Nivek-domotic/ttgo-cc2652p2/README.md

passerelle Zigbee CC2652 +TTGO
Le système est composé de 2 cartes, la TTGO avec un ESP32
Et une carte sur mesure composé d’un coordinateur Zigbee CC2652P2
