Nivek-domotic/ttgo-cc2652p2/Utilisation passerelle Zigbee CC2652.pdf

# Utilisation passerelle Zigbee CC2652 +TTGO

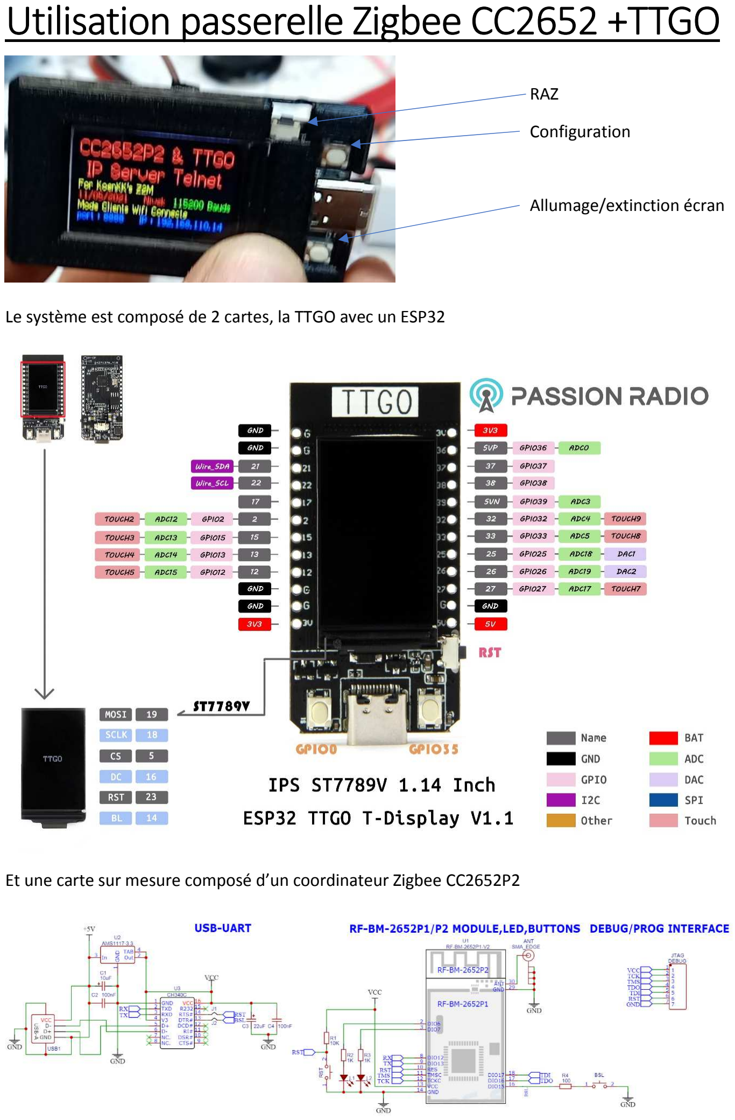
[picture p1: page 1]

RAZ

Configuration

Allumage/extinction écran

Le système est composé de 2 cartes, la TTGO avec un ESP32

Et une carte sur mesure composé d’un coordinateur Zigbee CC2652P2

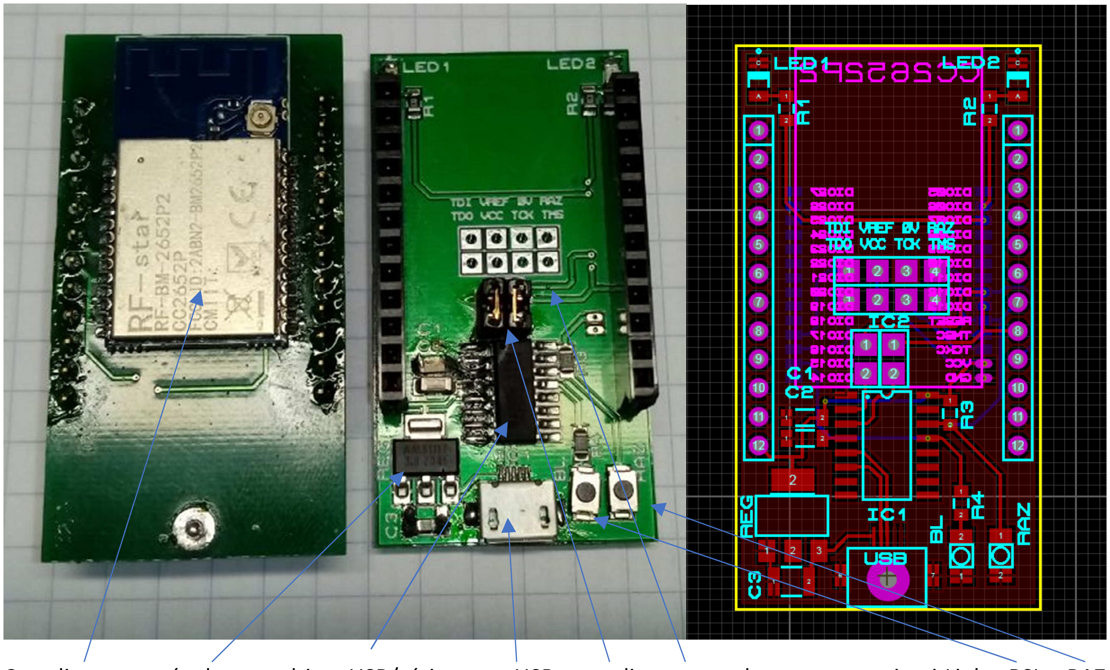
[picture p2: figure]

Coordinateur – régulateur - driver USB/série - port USB – cavaliers – port de programmation j-Link – BSL – RAZ

Cette carte peut être branchée directement sur la box Jeedom en USB avec les cavaliers.

Dans ce mode on pourrait la flasher directement en la passant en mode BSL (BOOT Start Loader) en appuyant sur le bouton BSL et en branchant l’USB puis en relâchant le bouton BSL (non testé)

Le flash, firmware et les conseils sont décrite sur le site de KOENKK créateur de Z2M

https://github.com/Koenkk/Z-Stack-firmware/tree/master/coordinator/Z-Stack_3.x.0/bin

la bonne version a utiliser dans notre cas est

CC1352P2_CC2652P_launchpad_coordinator_20210120.zip.

Pour un fonctionnement avec la TTGO il faut enlever les cavalier car c’est la TTGO qui va virtualiser la connexion série en IP par le protocole « Telnet » sur le port « 8888 »

Les port port virtualiser la connexion serie tx rx du coordinateur sont les gpio 26 et 25 le reset du coordinateur est en port gpio 33.

# UTILISATION

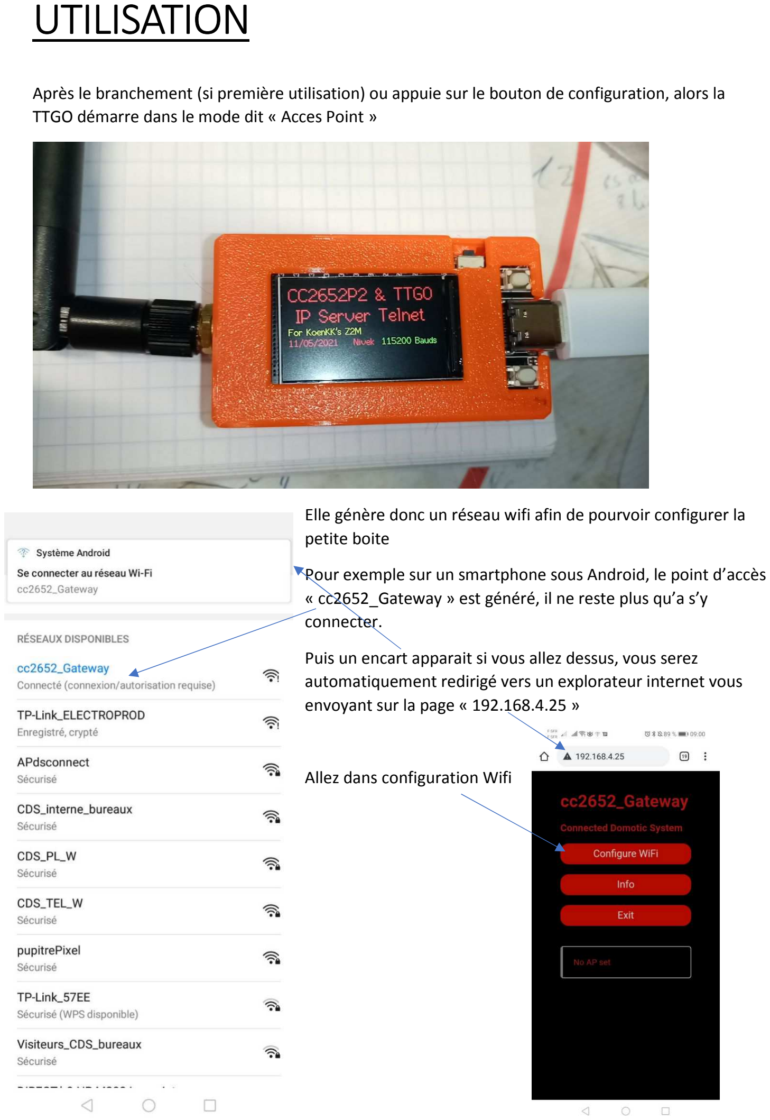
[picture p3: page 3]

Après le branchement (si première utilisation) ou appuie sur le bouton de configuration, alors la TTGO démarre dans le mode dit « Acces Point »

Elle génère donc un réseau wifi afin de pourvoir configurer la petite boite

Pour exemple sur un smartphone sous Android, le point d’accès « cc2652_Gateway » est généré, il ne reste plus qu’a s’y connecter.

Puis un encart apparait si vous allez dessus, vous serez automatiquement redirigé vers un explorateur internet vous envoyant sur la page « 192.168.4.25 »

Allez dans configuration Wifi

Renseigner votre SSID et mot de passe de votre wifi

Puis « Save »

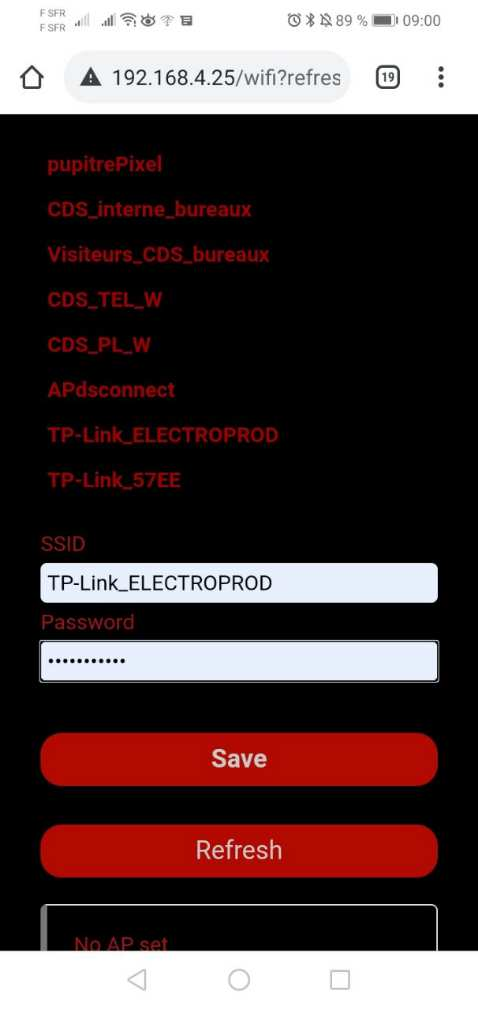
[picture p4: figure]

Le boitier redémarre après avoir enregistré dans sont EEPROM vos informations, ce qui permettra de les avoir en mémoire après une coupure de courant ou un redémarrage.

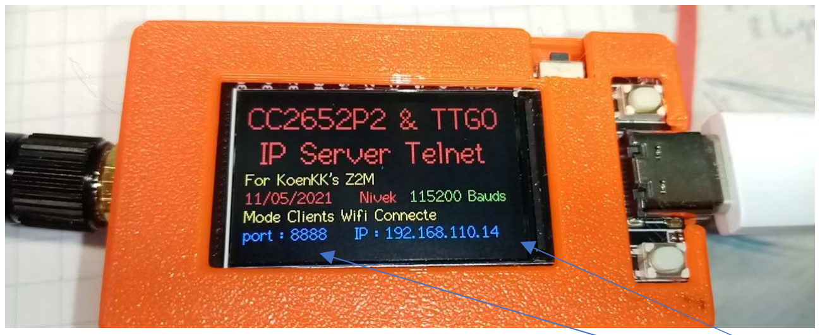
[picture p5: figure]

Le DIY redémarre donc sur le réseau wifi en indiquant le port et l’adresse IP a reporter dans le plugin ZigbeeLinker.

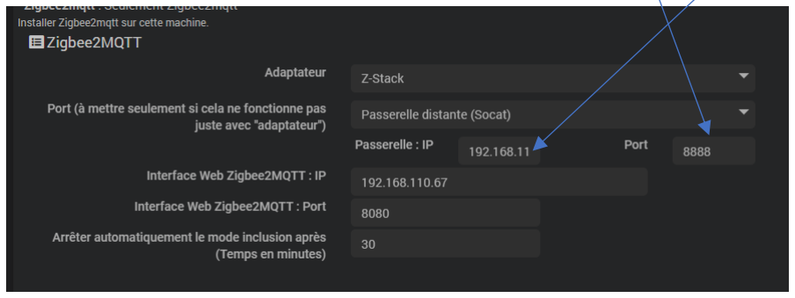
[picture p6: figure]
