Nivek-domotic/ttgo-cc2652p2/3d.png

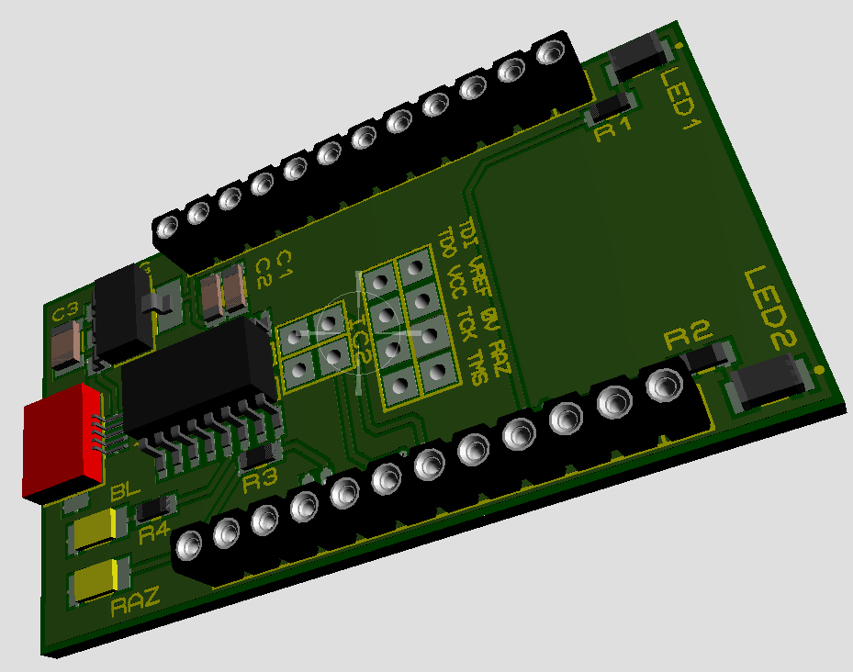
3d.png
