Nivek-domotic/ttgo-cc2652p2/bom (2).xls

Comment | Designator | Package | LCSC Part
2.2µf | C2 | 1206_CAP | C50254
usb-b | USB | USB | C404968
10KΩ | R3 | 0805_RES | C17414
100µf | C3 | 1210_CAP | C171668
CH340C | IC1 | SOP16 | C84681
 | RAZ,BL | BP | C720477
AP2114H | REG | SOT223-3 | C6186
1KΩ | R2,R1 | 0805_RES | C17513
100nf | C1 | 1206_CAP | C24497
 | LED2,LED1 | LEDC3216X120 | C273619
100Ω | R4 | 0805_RES | C17408
 | CON1,CON2 | HDR-TH_12P-P2.00-V | C124399
