Nivek-domotic/ttgo-cc2652p2/STL/TTGO-T-Display-bottom-battery.stl

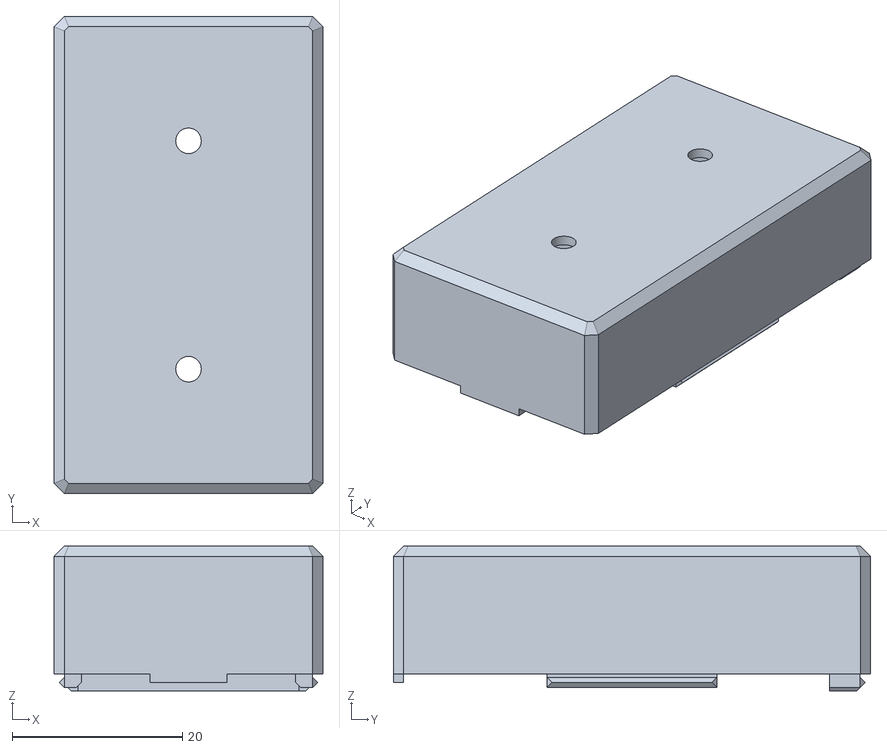
[picture p8: CAD file, 2021-06-16]
STL/TTGO-T-Display-bottom-battery.stl
31.5 x 56.0 x 17.0
