Nivek-domotic/ttgo-cc2652p2/STL/TTGO-T-Display-top.stl

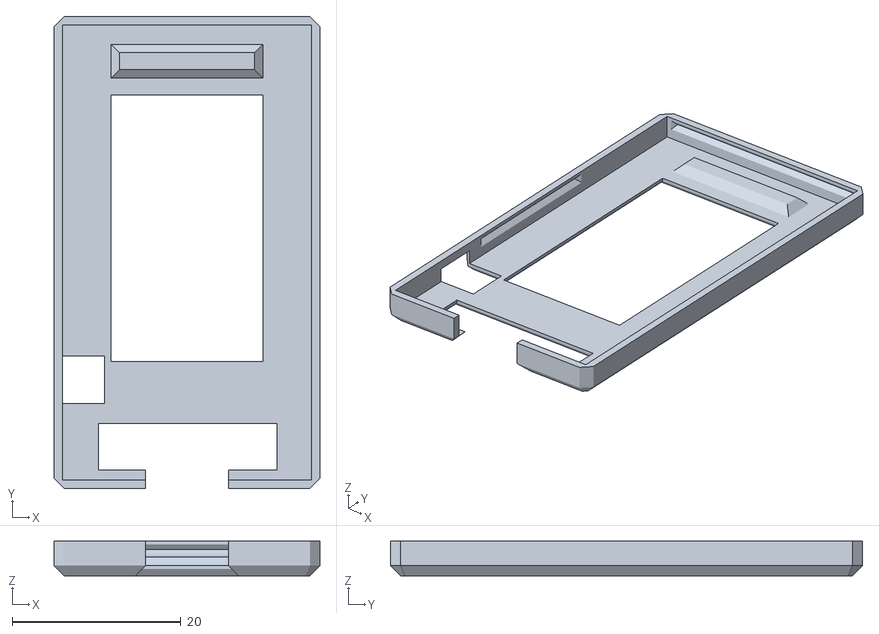
[picture p9: CAD file, 2021-06-16]
STL/TTGO-T-Display-top.stl
31.5 x 56.0 x 4.10
